Hamid-Najafi/C1-Laminar-Air-Flow-Reciculation/Docs/راهنمای نصب/RS232.jpg

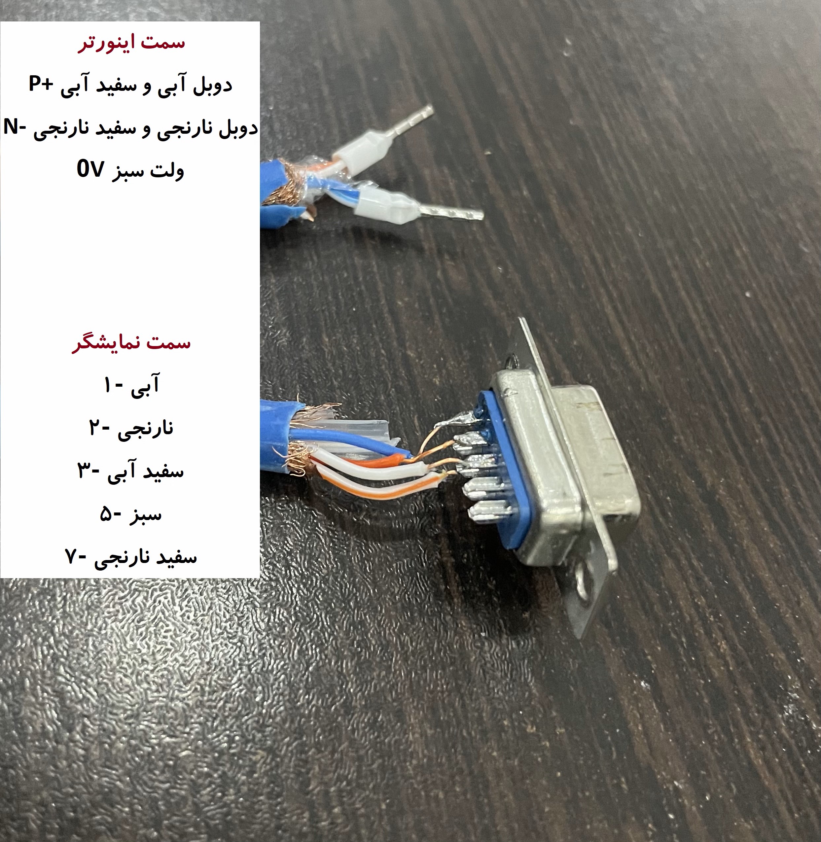
Docs/راهنمای نصب/RS232.jpg
