Hamid-Najafi/C1-Laminar-Air-Flow-Reciculation/Docs/Pictures/PHOTO-2022-05-05-09-01-35.jpg

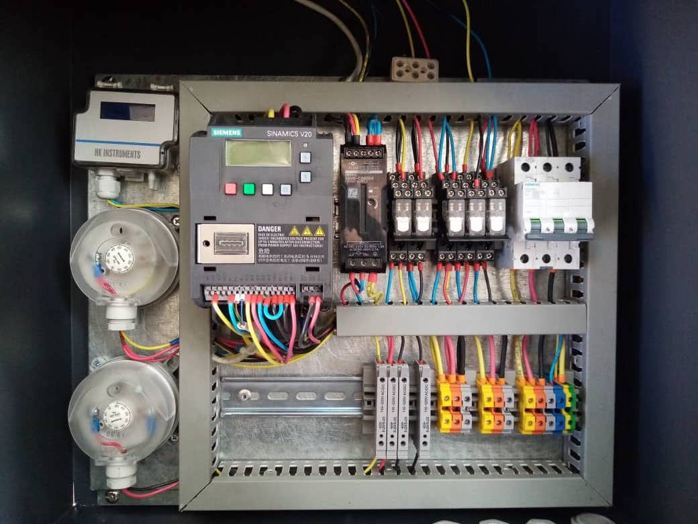
Docs/Pictures/PHOTO-2022-05-05-09-01-35.jpg
