Hamid-Najafi/C1-Laminar-Air-Flow-Reciculation/README.md

# Operating Room Laminar Air Flow Reciculation System

The system consists of Inverter (SINAMICS V20), HMI (Schneider Magelis), DPT & DPS (HK Instruments)
