Hamid-Najafi/C1-Laminar-Air-Flow-Reciculation/Docs/2828R پروپوزال/Proposal (01-04-06).pdf

## فهرست

Error! Bookmark not defined | فیلتر
Error! Bookmark not defined | نار لمی
ماژول 1 11 |
ماژول 2 12 |
فن 13 |
دی تا شی ت فن 13 |

## اتاق

ابعاد اتاق: c 300 × 580 × 710

ابعاد خروجی ها اگزاست: 4 گروه با ابعاد c 50 × 40 & 50 × 20

ابعاد فیلتر ها هوای برگشت: c 30 × 240

ابعاد درها:

در اصلی: c 210 × 150

درهای اسکراب: c 210 × 90
⁄c | سرعت خروجی هوا از لمینار: 35

میزان هوای خروجی از لمینار : FC 3200

میزان هوای ریسایکل : FC 1600

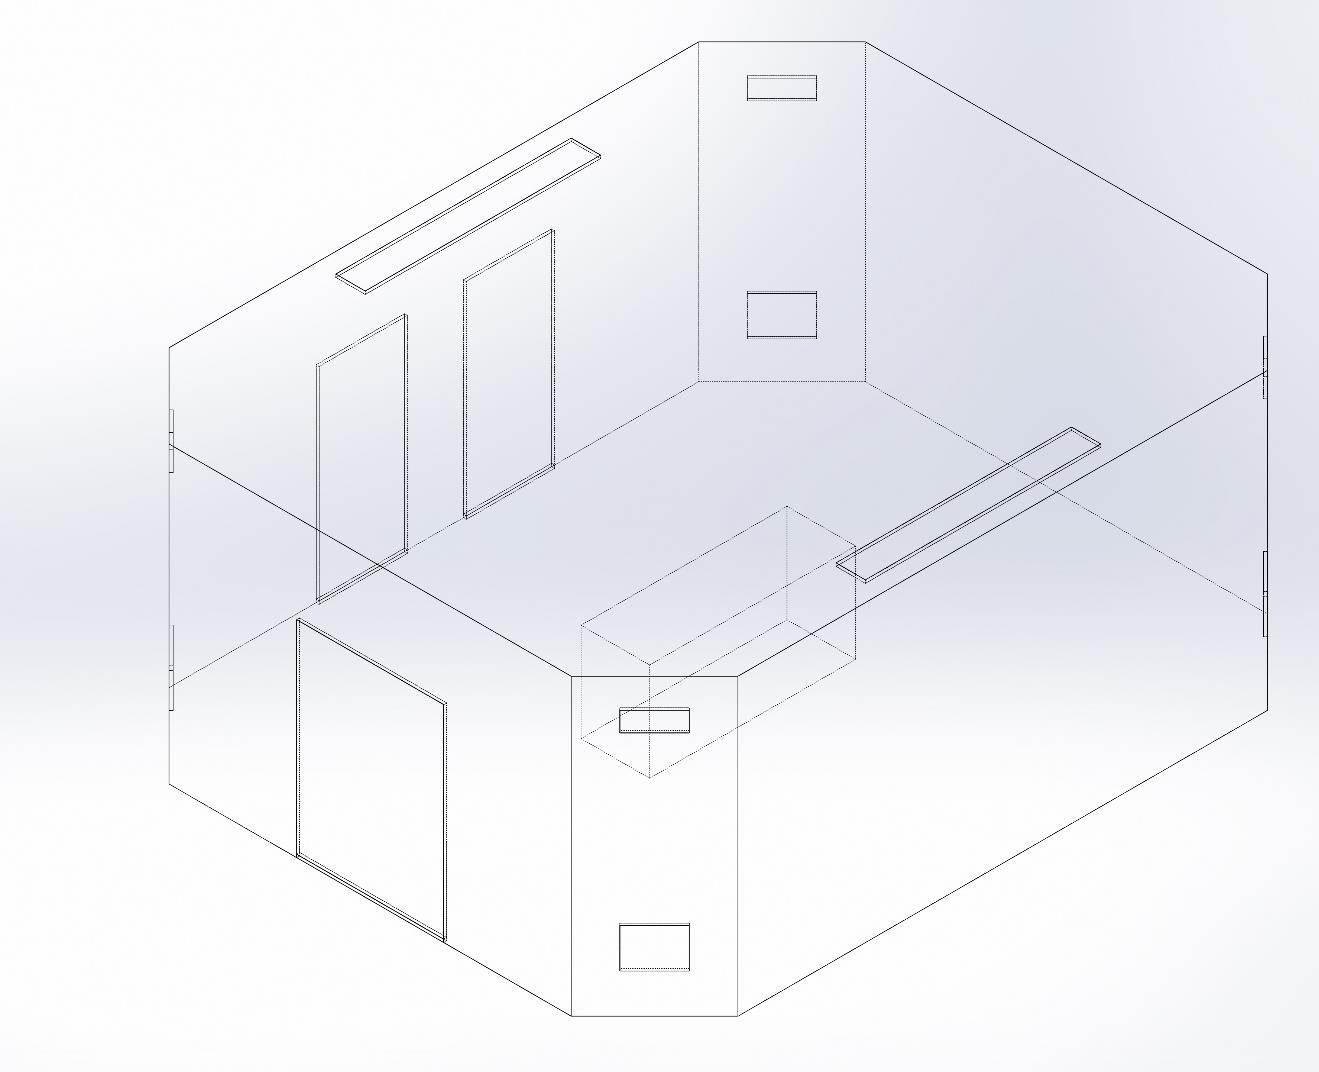
[picture p8: figure]

عکس 1 - شماتیک اتاق

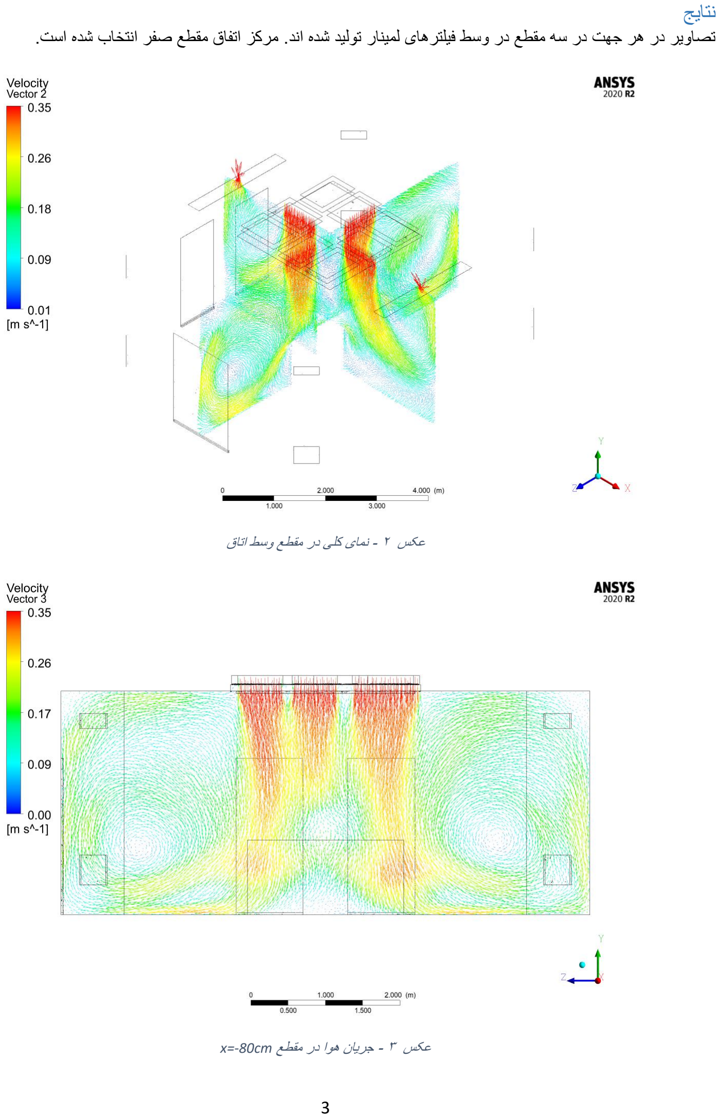
[picture p9: page 3]

نتایج
تصاویر در هر جهت در سه مقطع در وسط فیلترهای لمینار تولید شده اند. مرکز اتفاق مقطع صفر انتخاب شده است.

عکس 2 - نمای کلی در مقطع وسط اتاق

عکس 3 - جریان هوا در مقطع cm-80=x

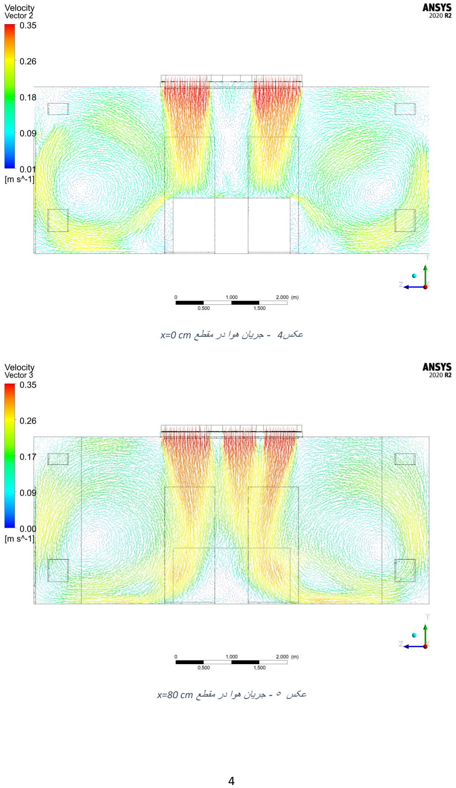
[picture p10: page 4]

عکس4 - جریان هوا در مقطع cm 0=x

عکس ⁵ - جریان هوا در مقطع cm 80=x

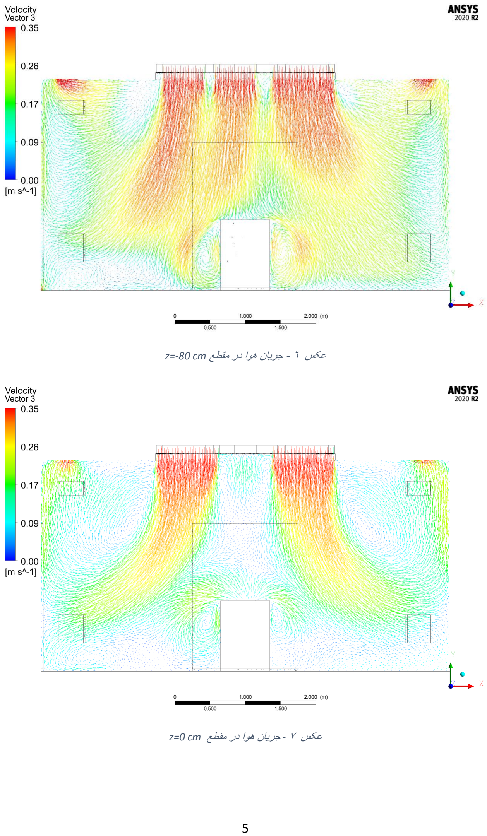
[picture p11: page 5]

عکس 6 - جریان هوا در مقطع cm -80=z

عکس 7 - جریان هوا در مقطع cm 0=z

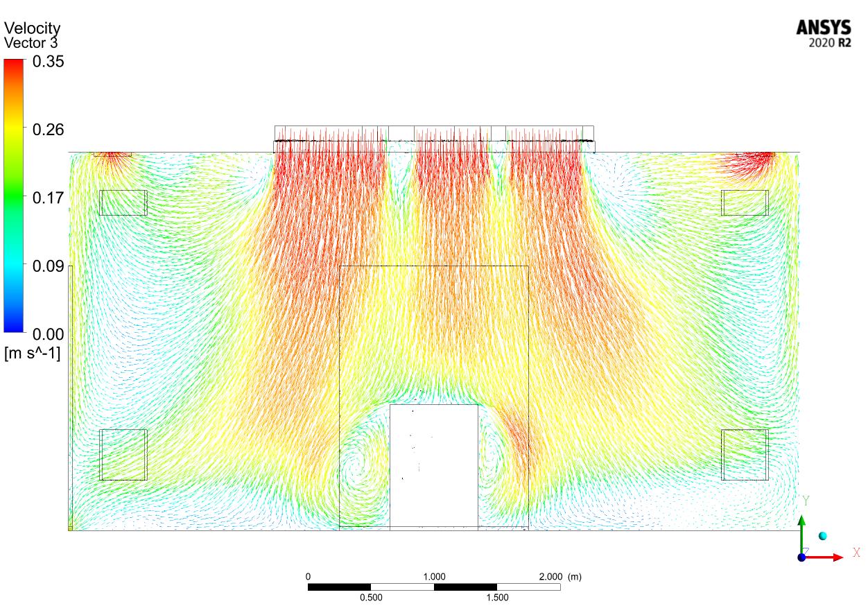
[picture p12: figure]

عکس 8 - جریان هوا در مقطع cm 80=z

## باکس فیلتر های هوای ریسایکل

برای خارج کردن و تامین هوای ریسایکل مورد نیاز برای لمینار، دو عدد باکس با مشخصات زیر طراحی شده است که هر باکس برای تامین FC 800 هوا طراحی شده اند.

مشخصات باکس
ابعاد باکس:

مشخصات فیلتر
نوع فیلتر: 7F

افت فشار اولیه فیلتر: P 65

افت فشار نهایی فلیتر : P 165

ابعاد فیلتر: c 67 × 28.7 × 28.7

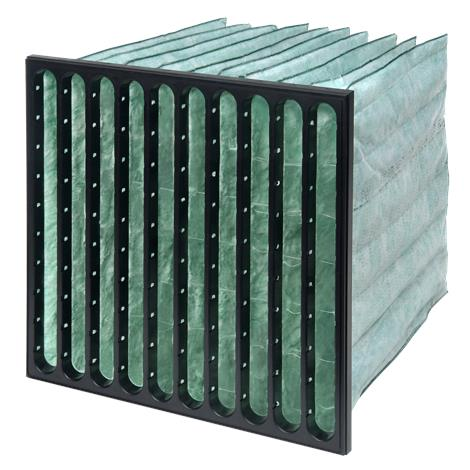
[picture p13: figure]

عکس 9 - فیلتر 7F

## کانال ها

بخش :1 کانال های رابط باکس 7F به فن ها ابعاد کانال
واحد ابعاد، سانتیمتر می باشد.

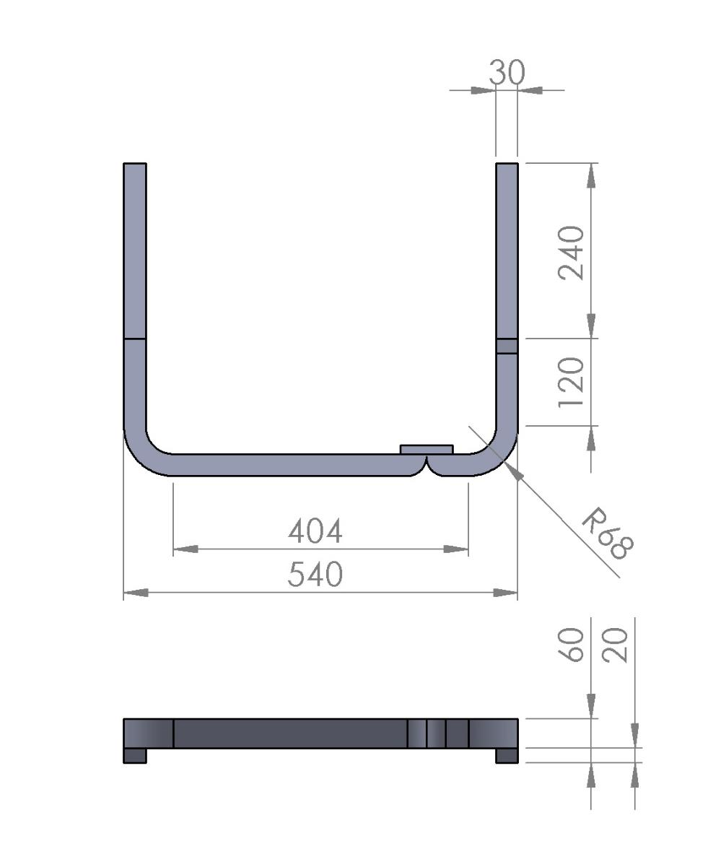
[picture p14: figure]

عکس 10 - شماتیک و ابعاد کانال 1

سرعت هوا در داخل کانال

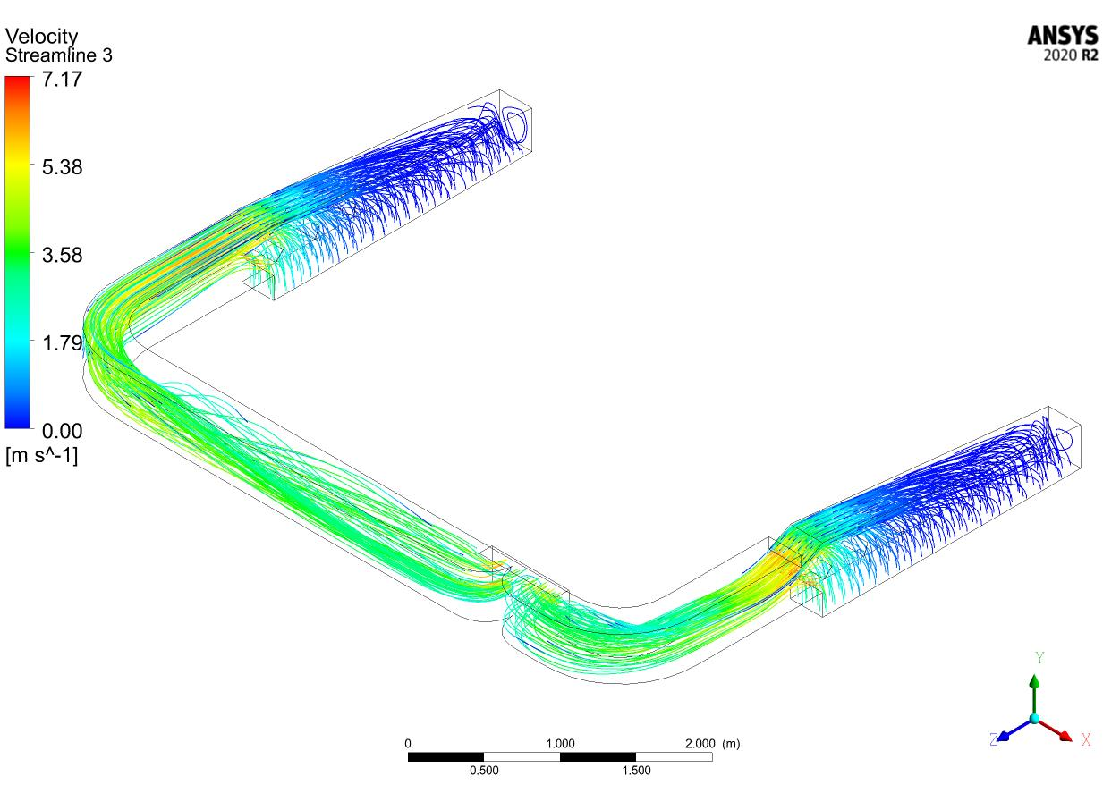
[picture p15: figure]

عکس 11 - خطوط سرعت هوا در کانال 1

نوع فیلترهای خروجی : -14HEPA

ابعاد فیلتر ها : c 15 × 61 × 90

افت فشار اولیه : P 250

افت فشار نهایی : P 500

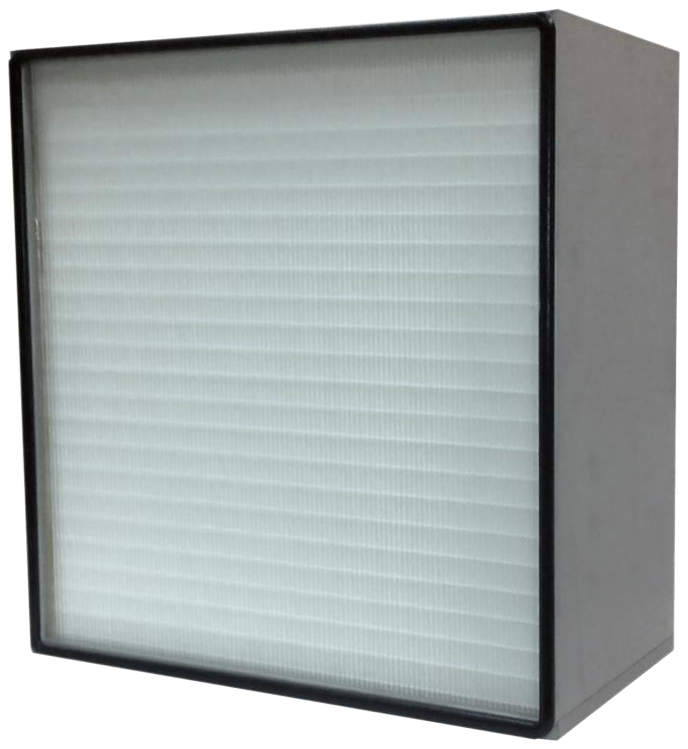
[picture p16: figure]

عکس 12 - فیلتر 14 HEPA

ماژول 1

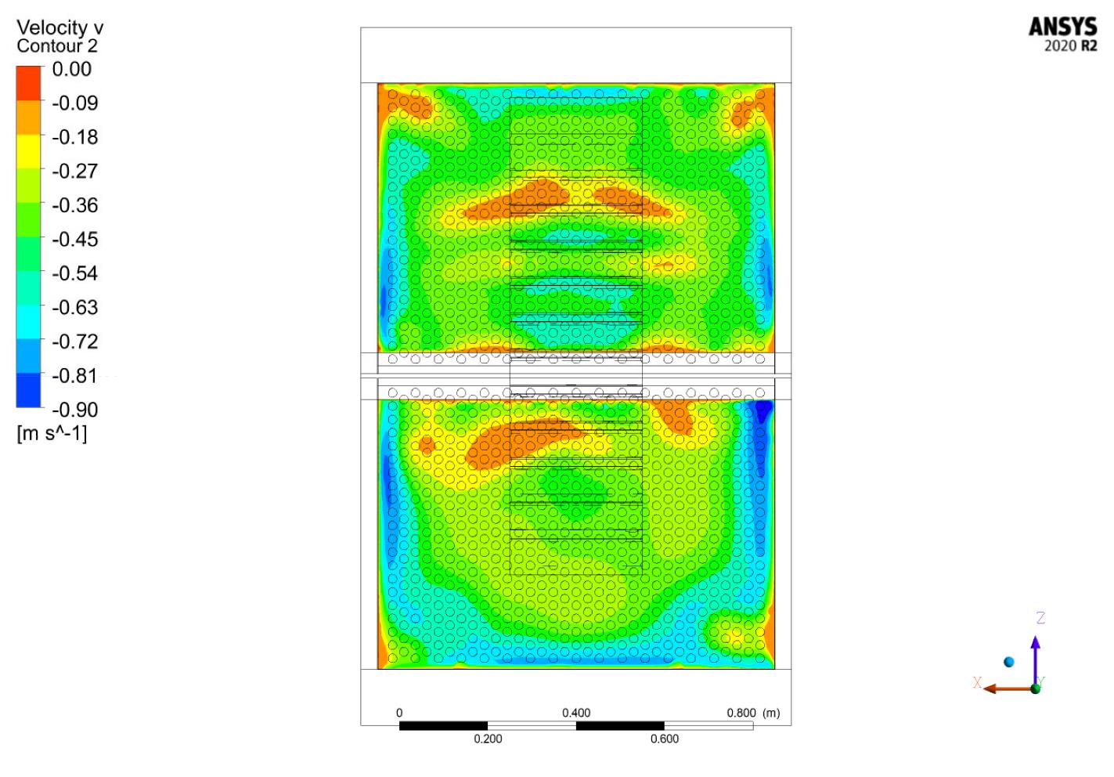
[picture p17: figure]

عکس 13 - توزیع سرعت عمودی خروجی بر روی فیلتر های ماژول 1

### ماژول 2

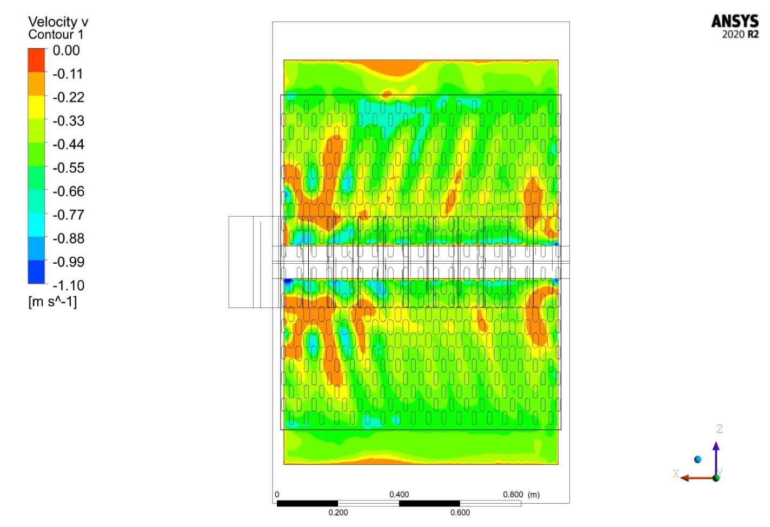
[picture p18: figure]

عکس 14 - توزیع سرعت عمودی بر روی فیلتر های ماژول 2

فن
دیتا شیت فن

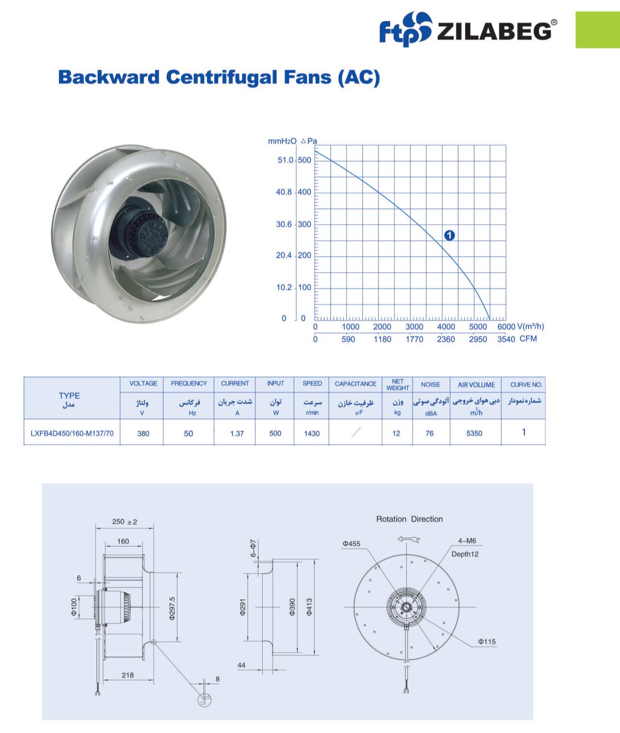
[picture p19: figure]
