Hamid-Najafi/C1-Laminar-Air-Flow-Reciculation/Docs/2828R پروپوزال/سیستم برق سانتریفیوژ (00-04-06).pdf

## سیســــــتم الكتریكـــــــال ســــــــــانتریفیوژ

A A VAKILZADEH

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
| NAME | SIGNATURE | DATE | 1401/04/06
DRAWN | | | DWG NO.
REVISION | Rev. | | SCALE:1:1 | SHEET 1 OF 5
سـطح محل | / ســـیم كابـــل مقطــع
| كابـــل-افشــــان 2.5 * 5 از منبــــع تــــامین سه فـــاز بــه تــــــابلو ســـــــــــانتریفیوژ
| كابـــل - افشــــان 1 * 4 از محل فرمــان (اضــطراری) بــه تــــــابلو ســـــــــــانتریفیوژ
| كابـــل -افشــــان 1 * 3 از تــــــابلو ســـــــــــانتریفیوژ بــه محل تــاچ پنــــل
| كابـــل شــــیلد و فویــــل- مفتولــــــی 0.25 * 6 از تــــــابلو ســـــــــــانتریفیوژ بــه محل تــاچ پنــــل

جدول كابـــل كشـــی تــــــابلو ســـــــــــانتریفیوژ اتـــاق عمل

لازم بــه ذكـر می باشــــد در جدول بـــالا موارد ذیــل رعایــت شـود

الــف: كابـــل و ســـیم بــه تــــــابلو ســـــــــــانتریفیوژ حدود دو مــتر اضــــافه در نظــر گرفتــــــه شـود

ب: بــا توجــه بــه محل جانمــــایی تـــاچ پنــــل حدود یــک مــتر كابـــل اضــــافه در نظــر گرفتــــــه شـود

ج: موارد مصــــرفی تــــــابلو ســــــــــاتریفیوژ
R, S ,T , | ارت , | نــول

جدول كابـــل كشـــی تــــــابلو ســـــــــــانتریفیوژ اتـــاق عمل

## سیســــــتم الكتریكـــــــال ســــــــــانتریفیوژ

A A VAKILZADEH

B B

C C

D D

E E

F F

| NAME | SIGNATURE | DATE | 1401/04/06
DRAWN | | | DWG NO.
REVISION | Rev. | | SCALE:1:1 | SHEET 2 OF 5

شـــــماتیک مســـیر كابــــل كشـــی تــــــابلو ســـــــــــانتریفیوژ اتـــاق عمل

كابـــل 2.5 * 5

كابـــل 1 * 4 از محل فرمـــان/اضــطراری

كابـــل 0.25 * 6

4

كابـــل 1 * 3

پیشـــــــنهاد می گـردد محل قــرار گـــیری تـــاچ پنــــل در زیــر ســاعت و كرنومـــــتر اتـــاق عمل قــرار گـــیرد و ارتفـــــاع از كـف تمــام شـده اتـــاق عمل 180 ســـــانتی مــتر باشــــد

لازم بــه ذكـر می باشــــد كه عـلاوه بـــر خاموش-روشــن نمــودن ســـــــــــانتریفیوژ از تـــاچ پنــــل نقطـــه دیگـــری جهت اضــطراری بـــودن تــــامین شـده اسـت نیــــاز بــه كابـــل فرمـــان بــه ســطح مقطــع كابـــل 1 * 4 از محل اضــطراری بــه تــــــابلو ســـــــــــانتریفیوژ مورد نیــــاز می باشــــد در صــورت صــلاح دیــد انجــام شـود. .در غــیر اینصـــــورت روی درب تــــــابلو ســـــــــــانتریفیوژ نصـــب می گـردد

## سیســــــتم الكتریكـــــــال ســــــــــانتریفیوژ

A A VAKILZADEH

B B

C C

D D

E E

F F

| NAME | SIGNATURE | DATE | 1401/04/06
DRAWN | | | DWG NO.
REVISION | Rev. | | SCALE:1:1 | SHEET 3 OF 5
| | | W تـــوان A شــدت جریــان HZ فركـــــانس V ولتــــاژ
380 | 50 | 4 | 1500

مشـخات فــــنی تــــــابلو ســـــــــــانتریفیوژ اتـــاق عمل

## سیســــــتم الكتریكـــــــال ســــــــــانتریفیوژ

A A VAKILZADEH

B B

C C

D D

E E

F F

| NAME | SIGNATURE | DATE | 1401/04/06
DRAWN | | | DWG NO.
REVISION | Rev. | | SCALE:1:1 | SHEET 4 OF 5

## سیســــــتم الكتریكـــــــال ســــــــــانتریفیوژ

A A VAKILZADEH

B B

C C

D D

E E

F F

| NAME | SIGNATURE | DATE | 1401/04/06
DRAWN | | | DWG NO.
REVISION | Rev. | | SCALE:1:1 | SHEET 5 OF 5
