Hamid-Najafi/C1-Laminar-Air-Flow-Reciculation/Docs/FlowMeter/Calc-ms-to-cfm.png

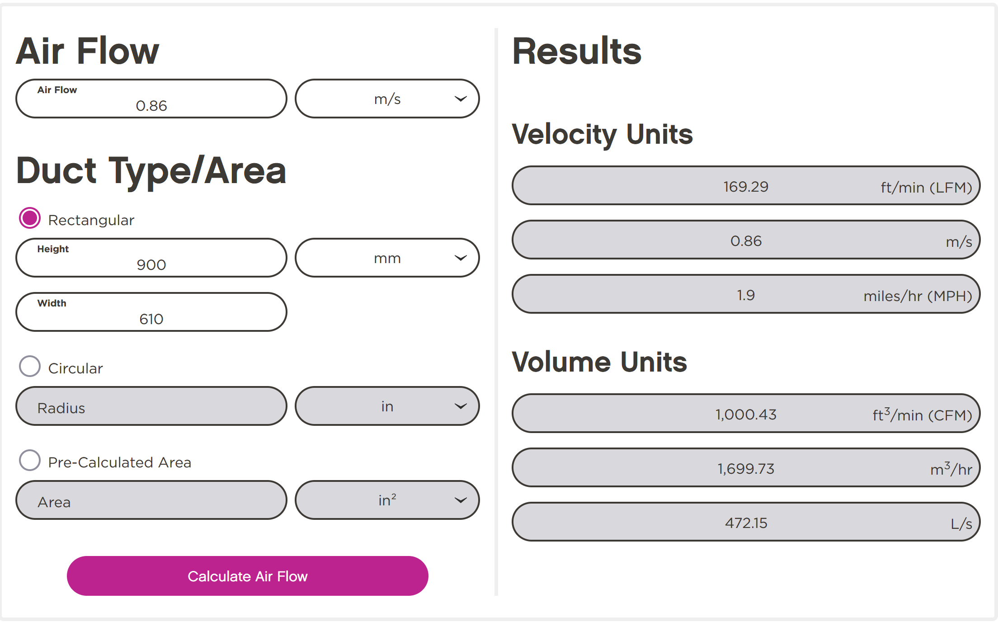
Docs/FlowMeter/Calc-ms-to-cfm.png
