Hamid-Najafi/C1-Laminar-Air-Flow-Reciculation/Docs/راهنمای نصب/سیم‌کشی تابلو.jpeg

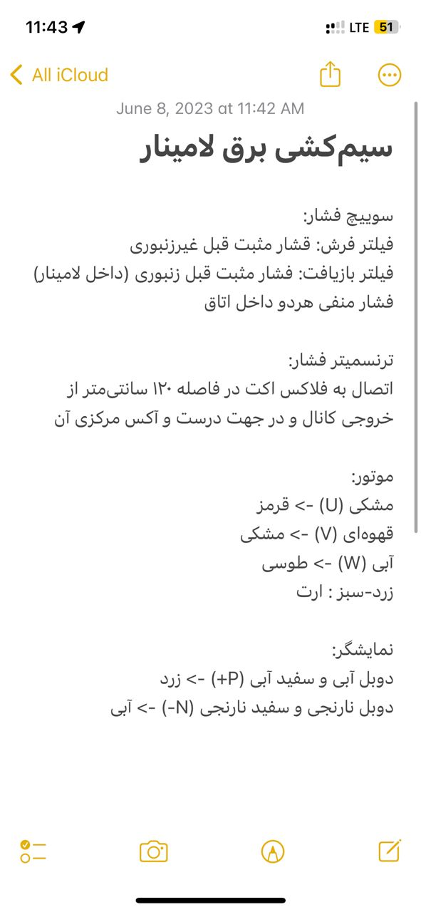
Docs/راهنمای نصب/سیم‌کشی تابلو.jpeg
