Hamid-Najafi/C1-Laminar-Air-Flow-Reciculation/Schneider Electric (Magelis HMI)/images/watermark-c1.jpg

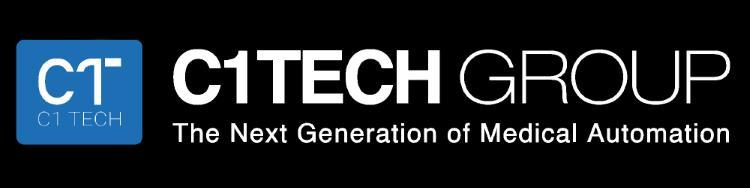
Schneider Electric (Magelis HMI)/images/watermark-c1.jpg
