Hamid-Najafi/C1-Laminar-Air-Flow-Reciculation/Siemens (SINAMICS V20)/Modbus Poll/Connection.png

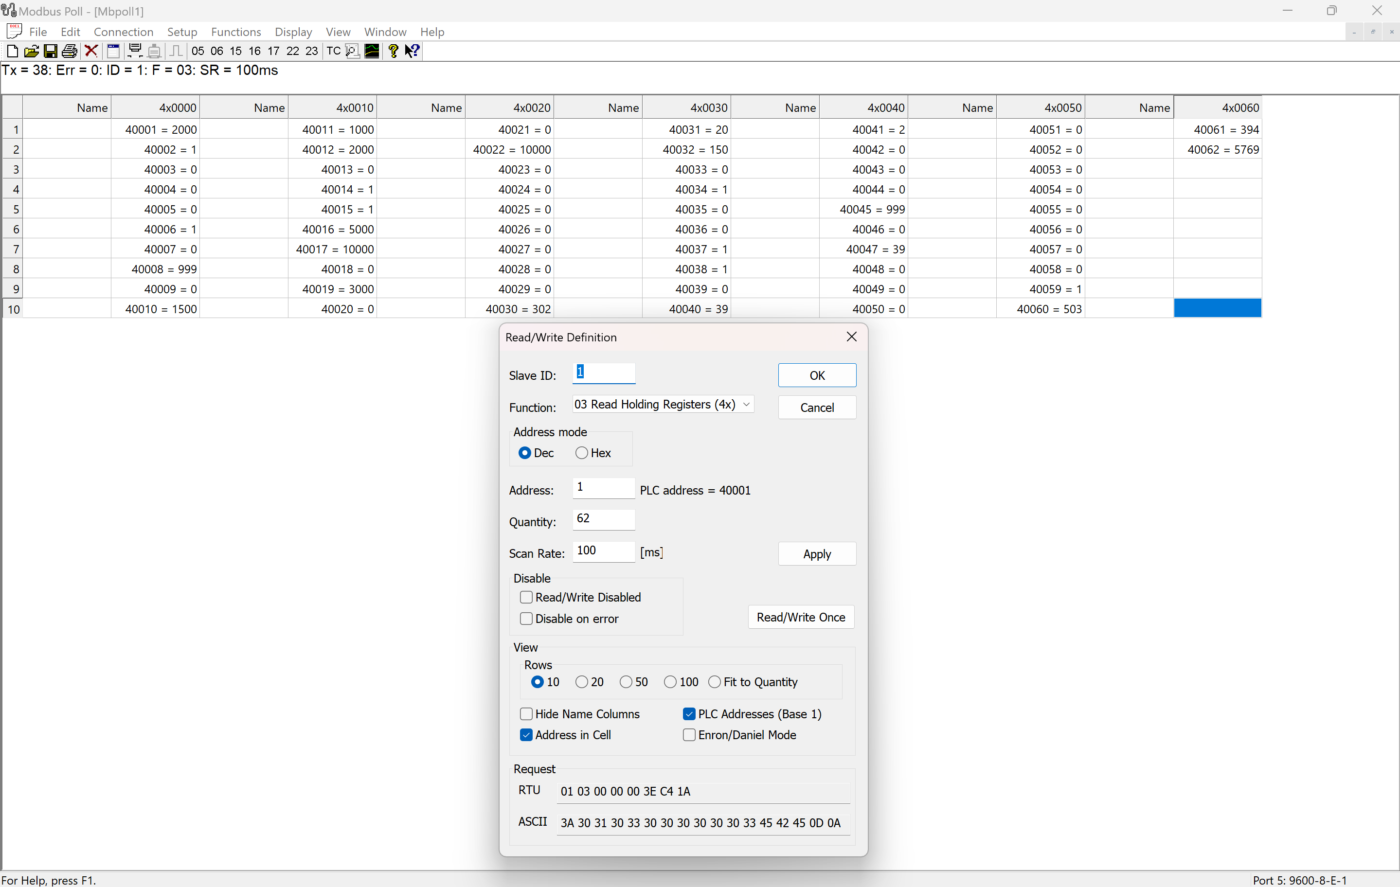
Siemens (SINAMICS V20)/Modbus Poll/Connection.png
