Hamid-Najafi/C1-Laminar-Air-Flow-Reciculation/Docs/Materials/BOM-LAF.pdf

Part # | Part Name | Description | Brand | Qty
5 | SINAMICS V20 | 6SL3210-5BE21-5UV0 | Siemens | 44
6 | HMIGXU3500 | 7 inch wide screen, Basic model, 1 serial port,
| | embedded RTC | Schneider Electric | 24
7 | Zelio Relay & Socket | RXG12BD | Schneider Electric | 0
8 | Zelio Relay & Socket | RXG22BD | Schneider Electric | 0
9 | PowerSupply | 24v, 10A | MeanWell | 44
10 | Signal Light | Red, 220V AC | ParsFanal | 100
11 | Circuit Breaker & Fuse | 6A, 6kV | Schneider Electric | 0
13 | Wire & Label | 1.5 in 10 Color, 2.5 in 3 Color - Label Pack | Other | 1
