Hamid-Najafi/C1-Laminar-Air-Flow-Reciculation/Docs/Materials/HK/DTP Flow/Flow-equations-2.0.pdf

www.hkinstruments.fi | 2.0 2022

## FLOW EQUATIONS

Manufacturer of the fan | Equation | K-factor range | Unit of the equation
FläktWoods | k q = ⋅ ∆ 1 P | 0.3...99 | m³ /s
Rosenberg | q k ⋅ ∆ = ⋅ 2 P ρ | 37...800 | m³ /h
Nicotra-Gebhardt | q k ⋅ ∆ = ⋅ 2 P * ρ | 50...4700 | m³ /h
Comefri | q k ⋅ ∆ = ⋅ 2 P ρ | 10...2000 | m³ /h
Ziehl | q = k ⋅ ∆P | 10...1500 | m³ /h
ebm-papst | q = k ⋅ ∆P | 10...1500 | m³ /h
Gebhardt | q k ⋅ ∆ = ⋅ 2 P ρ | 50...4700 | m³ /h
Nicotra | q = k ⋅ ∆P | 50...5300 | m³ /h
Common probe (e.g. FloXact) | q = k ⋅ ∆P | 0,001...9999,000 | m³ /h

Each manufacturer has its own equation, K-factor range and unit of equation (see table below). By selecting the manufacturer from the menu, correct settings for each manufacturer will automatically be used.

q = air flow | k = k-factor | ΔP = differential pressure | ρ = air density

k= C*sqrt(1.2/ρ)
ρ = air density [kg·m3] (1.2 at 20°C, 50% r.h. and 1013.2 hPa)

*
