Hamid-Najafi/C1-Laminar-Air-Flow-Reciculation/Docs/Materials/BOM-LAF.xlsx

Sheet: BillOfMaterials
Bill of Materials
 | Assembly Name : | Laminar Air Flow Recirculation Unit |  | [42]
 | Assembly Number : | --
 | Assembly Revision : | 1
 | Approval Date : | 1401/11/10
 | Part Count : | 11
 | Total Cost : | 5613500000.0ریال
Part # | Part Name | Description | Brand | Qty | Units | Unit Cost | Cost (one sys)
1 | LXFB4D450/160-M137/070 | Backward Centrifugal Fan | Ziehl-Abegg | 1 | each | 0ریال | 0ریال
2 | DPT-Flow_x0002_1000-AZ-D | Air flow and velocity transmitters | HK Instruments | 1 | each | 0ریال | 0ریال
3 | PS1500 | Mechanical differential pressure switches for air | HK Instruments | 2 | each | 0ریال | 0ریال
4 | FloXact™-L400 | Air flow and velocity transmitters | HK Instruments | 1 | each | 0ریال | 0ریال
5 | SINAMICS V20 | 6SL3210-5BE21-5UV0 | Siemens | 44 | each | 95000000ریال | 4180000000ریال
6 | HMIGXU3500 | 7 inch wide screen, Basic model, 1 serial port, embedded RTC | Schneider Electric | 24 | each | 39000000ریال | 936000000ریال
7 | Zelio Relay & Socket | RXG12BD | Schneider Electric | 0 | each | 3500000ریال | 0ریال
8 | Zelio Relay & Socket | RXG22BD | Schneider Electric | 0 | each | 3500000ریال | 0ریال
9 | PowerSupply | 24v, 10A | MeanWell | 44 | each | 10000000ریال | 440000000ریال
10 | Signal Light | Red, 220V AC | ParsFanal | 100 | each | 500000ریال | 50000000ریال
11 | Circuit Breaker & Fuse | 6A, 6kV | Schneider Electric | 0 | each | 7000000ریال | 0ریال
13 | Wire & Label | 1.5 in 10 Color, 2.5 in 3 Color - Label Pack | Other | 1 | each | 7500000ریال | 7500000ریال
 | Total |  |  | 218 |  |  | 5613500000.0ریال

Sheet: Revisions
Revision History
 | Assembly Name :
 | Assembly Number :
Revision | Revision Summary | Approval Date
0.1 | Initial release. | 2020-04-13
