Hamid-Najafi/C1-Laminar-Air-Flow-Reciculation/Docs/Materials/Ziehl-Abegg Backward Centrifugal Fan/ZILABEG.pdf

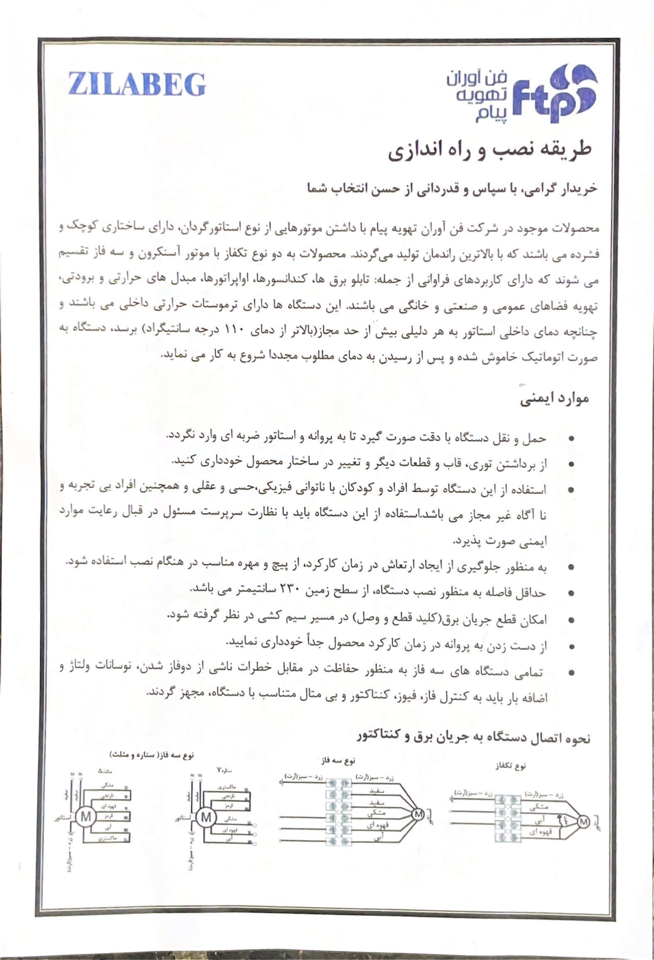
[picture p24: page 1]
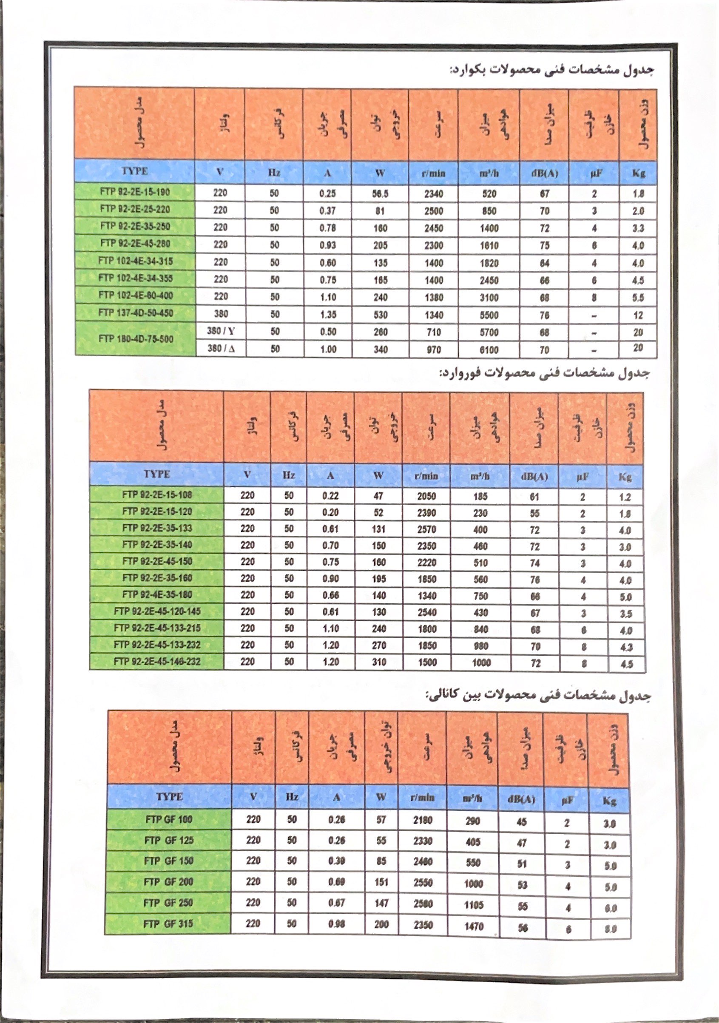
[picture p25: page 2]

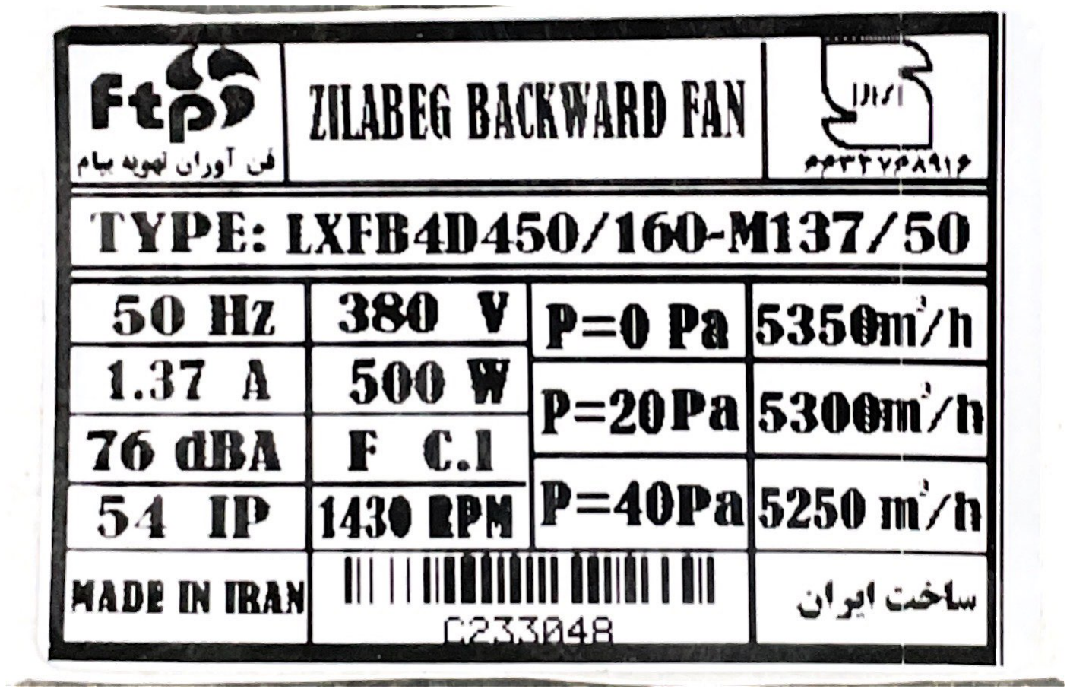
[picture p26: figure]
