Hamid-Najafi/C1-Laminar-Air-Flow-Reciculation/Schneider Electric (Magelis HMI)/Vijeo Designer Variables/SINAMICS V20 Modbus Vijeo Variable.CSV

'5.1.0 | Vijeo-Designer 6.2.6 CSV output
Type | Name | Data Type | Data Source | Dimension | Description | Initial Value | NumofBytes | Data Sharing | Alarm | Language1 ID | Alarm Message | Alarm Type | Trigger Condition | Deadband | Target | LoLo\Lo\Hi\HiHi | Minor | Major | Alarm Group | Severity | Vibration Pattern | Vibration Time | Sound File | Play Mode | Scan Group | Device Address | Bit Number | Data Format | Signed | Data Length | Offset Bit No | Bit Width | InputRange | Min | Max | DataScaling | RawMin | RawMax | ScaledMin | ScaledMax | IndirectEnabled | IndirectAddress | Retentive | LoggingGroup | LogUserOperationsOnVariable
Folder | SINAMICS_V20_VAR
Variable | SINAMICS_V20_VAR.WDOG_TIME | INT | External | 0 | HZ |  |  | None | Disable | 1 |  |  |  |  |  |  |  |  |  |  |  |  |  |  | ModbusEquipment01 | 40001 |  | BIN | 2sComplement | 16Bits |  |  | Disable |  |  | Disable |  |  |  |  | Disable |  |  |  | Disable
Variable | SINAMICS_V20_VAR.INVERTER_VER | INT | External | 0 | HZ |  |  | None | Disable | 1 |  |  |  |  |  |  |  |  |  |  |  |  |  |  | ModbusEquipment01 | 40061 |  | BIN | 2sComplement | 16Bits |  |  | Disable |  |  | Disable |  |  |  |  | Disable |  |  |  | Disable
Variable | SINAMICS_V20_VAR.WDOG_ACTION | INT | External | 0 | HZ |  |  | None | Disable | 1 |  |  |  |  |  |  |  |  |  |  |  |  |  |  | ModbusEquipment01 | 40002 |  | BIN | 2sComplement | 16Bits |  |  | Disable |  |  | Disable |  |  |  |  | Disable |  |  |  | Disable
Variable | SINAMICS_V20_VAR.DRIVE_MODEL | INT | External | 0 | HZ |  |  | None | Disable | 1 |  |  |  |  |  |  |  |  |  |  |  |  |  |  | ModbusEquipment01 | 40062 |  | BIN | 2sComplement | 16Bits |  |  | Disable |  |  | Disable |  |  |  |  | Disable |  |  |  | Disable
Variable | SINAMICS_V20_VAR.Reserved | INT | External | 0 | HZ |  |  | None | Disable | 1 |  |  |  |  |  |  |  |  |  |  |  |  |  |  | ModbusEquipment01 | 40013 |  | BIN | 2sComplement | 16Bits |  |  | Disable |  |  | Disable |  |  |  |  | Disable |  |  |  | Disable
Variable | SINAMICS_V20_VAR.FREQ_OUTPUT | INT | External | 0 | HZ |  |  | None | Disable | 1 |  |  |  |  |  |  |  |  |  |  |  |  |  |  | ModbusEquipment01 | 40024 |  | BIN | 2sComplement | 16Bits |  |  | Disable |  |  | Disable |  |  |  |  | Disable |  |  |  | Disable
Variable | SINAMICS_V20_VAR.STOP_RUN | BOOL | External | 0 | HZ |  |  | None | Disable | 1 |  |  |  |  |  |  |  |  |  |  |  |  |  |  | ModbusEquipment01 | 40035 | 00 |  |  |  |  |  |  |  |  |  |  |  |  |  | Disable |  |  |  | Disable
Variable | SINAMICS_V20_VAR.PID_FEEDBACK | INT | External | 0 | HZ |  |  | None | Disable | 1 |  |  |  |  |  |  |  |  |  |  |  |  |  |  | ModbusEquipment01 | 40047 |  | BIN | 2sComplement | 16Bits |  |  | Disable |  |  | Disable |  |  |  |  | Disable |  |  |  | Disable
Variable | SINAMICS_V20_VAR.F2_FAULT | INT | External | 0 | HZ |  |  | None | Disable | 1 |  |  |  |  |  |  |  |  |  |  |  |  |  |  | ModbusEquipment01 | 40057 |  | BIN | 2sComplement | 16Bits |  |  | Disable |  |  | Disable |  |  |  |  | Disable |  |  |  | Disable
Variable | SINAMICS_V20_VAR.F3_FAULT | INT | External | 0 | HZ |  |  | None | Disable | 1 |  |  |  |  |  |  |  |  |  |  |  |  |  |  | ModbusEquipment01 | 40058 |  | BIN | 2sComplement | 16Bits |  |  | Disable |  |  | Disable |  |  |  |  | Disable |  |  |  | Disable
Variable | SINAMICS_V20_VAR.WARNING | BOOL | External | 0 | HZ |  |  | None | Disable | 1 |  |  |  |  |  |  |  |  |  |  |  |  |  |  | ModbusEquipment01 | 40059 | 00 |  |  |  |  |  |  |  |  |  |  |  |  |  | Disable |  |  |  | Disable
Variable | SINAMICS_V20_VAR.LAST_WARNING | INT | External | 0 | HZ |  |  | None | Disable | 1 |  |  |  |  |  |  |  |  |  |  |  |  |  |  | ModbusEquipment01 | 40060 |  | BIN | 2sComplement | 16Bits |  |  | Disable |  |  | Disable |  |  |  |  | Disable |  |  |  | Disable
Variable | SINAMICS_V20_VAR.FREQ_REF | INT | External | 0 | HZ |  |  | None | Disable | 1 |  |  |  |  |  |  |  |  |  |  |  |  |  |  | ModbusEquipment01 | 40003 |  | BIN | 2sComplement | 16Bits |  |  | Disable |  |  | Disable |  |  |  |  | Disable |  |  |  | Disable
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
Variable | SINAMICS_V20_VAR.PID_OUTPUT | INT | External | 0 | HZ |  |  | None | Disable | 1 |  |  |  |  |  |  |  |  |  |  |  |  |  |  | ModbusEquipment01 | 40046 |  | BIN | 2sComplement | 16Bits |  |  | Disable |  |  | Disable |  |  |  |  | Disable |  |  |  | Disable
Variable | SINAMICS_V20_VAR.DIGITAL_IN_1 | BOOL | External | 0 |  |  |  | Read Only | Enable | 1 |  |  | when high |  |  | _\_\_\_ |  |  | DPS_AlarmGroup | 1 |  |  |  |  | ModbusEquipment01 | 40048 | 00 |  |  |  |  |  |  |  |  |  |  |  |  |  | Disable |  |  |  | Disable
Variable | SINAMICS_V20_VAR.DIGITAL_IN_2 | BOOL | External | 0 | HZ |  |  | Read Only | Enable | 1 | Recycle Filter Dirty |  | when high |  |  | _\_\_\_ |  |  | DPS_AlarmGroup | 1 | Continuous | 10 |  |  | ModbusEquipment01 | 40049 | 00 |  |  |  |  |  |  |  |  |  |  |  |  |  | Disable |  |  |  | Disable
Variable | SINAMICS_V20_VAR.DIGITAL_IN_3 | BOOL | External | 0 | HZ |  |  | None | Disable | 1 |  |  |  |  |  |  |  |  |  |  |  |  |  |  | ModbusEquipment01 | 40050 | 00 |  |  |  |  |  |  |  |  |  |  |  |  |  | Disable |  |  |  | Disable
Variable | SINAMICS_V20_VAR.DIGITAL_IN_4 | BOOL | External | 0 | HZ |  |  | None | Disable | 1 |  |  |  |  |  |  |  |  |  |  |  |  |  |  | ModbusEquipment01 | 40051 | 00 |  |  |  |  |  |  |  |  |  |  |  |  |  | Disable |  |  |  | Disable
Variable | SINAMICS_V20_VAR.FAULT | BOOL | External | 0 | HZ |  |  | None | Disable | 1 |  |  |  |  |  |  |  |  |  |  |  |  |  |  | ModbusEquipment01 | 40054 | 00 |  |  |  |  |  |  |  |  |  |  |  |  |  | Disable |  |  |  | Disable
Variable | SINAMICS_V20_VAR.LAST_FAULT | INT | External | 0 | HZ |  |  | None | Disable | 1 |  |  |  |  |  |  |  |  |  |  |  |  |  |  | ModbusEquipment01 | 40055 |  | BIN | 2sComplement | 16Bits |  |  | Disable |  |  | Disable |  |  |  |  | Disable |  |  |  | Disable
Variable | SINAMICS_V20_VAR.F1_FAULT | INT | External | 0 | HZ |  |  | None | Disable | 1 |  |  |  |  |  |  |  |  |  |  |  |  |  |  | ModbusEquipment01 | 40056 |  | BIN | 2sComplement | 16Bits |  |  | Disable |  |  | Disable |  |  |  |  | Disable |  |  |  | Disable
Variable | SINAMICS_V20_VAR.STW_ControlWord | INT | External | 0 |  |  |  | None | Disable | 1 |  |  |  |  |  |  |  |  |  |  |  |  |  |  | ModbusEquipment01 | 40100 |  | BIN | 2sComplement | 16Bits |  |  | Disable |  |  | Disable |  |  |  |  | Disable |  |  |  | Disable
Variable | SINAMICS_V20_VAR.HSW_SpeedSetpoint | INT | External | 0 |  |  |  | None | Disable | 1 |  |  |  |  |  |  |  |  |  |  |  |  |  |  | ModbusEquipment01 | 40101 |  | BIN | 2sComplement | 16Bits |  |  | Disable |  |  | Disable |  |  |  |  | Disable |  |  |  | Disable
Variable | SINAMICS_V20_VAR.ZSW_StatusWord | INT | External | 0 |  |  |  | None | Disable | 1 |  |  |  |  |  |  |  |  |  |  |  |  |  |  | ModbusEquipment01 | 40110 |  | BIN | 2sComplement | 16Bits |  |  | Disable |  |  | Disable |  |  |  |  | Disable |  |  |  | Disable
Variable | SINAMICS_V20_VAR.HIW_ActualSpeed | DINT | External | 0 |  |  |  | None | Disable | 1 |  |  |  |  |  |  |  |  |  |  |  |  |  |  | ModbusEquipment01 | 40111 |  | BIN | 2sComplement | 32Bits |  |  | Disable |  |  | Disable |  |  |  |  | Disable |  |  |  | Disable
