Hamid-Najafi/C1-Laminar-Air-Flow-Reciculation/Docs/Materials/Ziehl-Abegg Backward Centrifugal Fan/LXFB4D450-160-M137-70.jpg

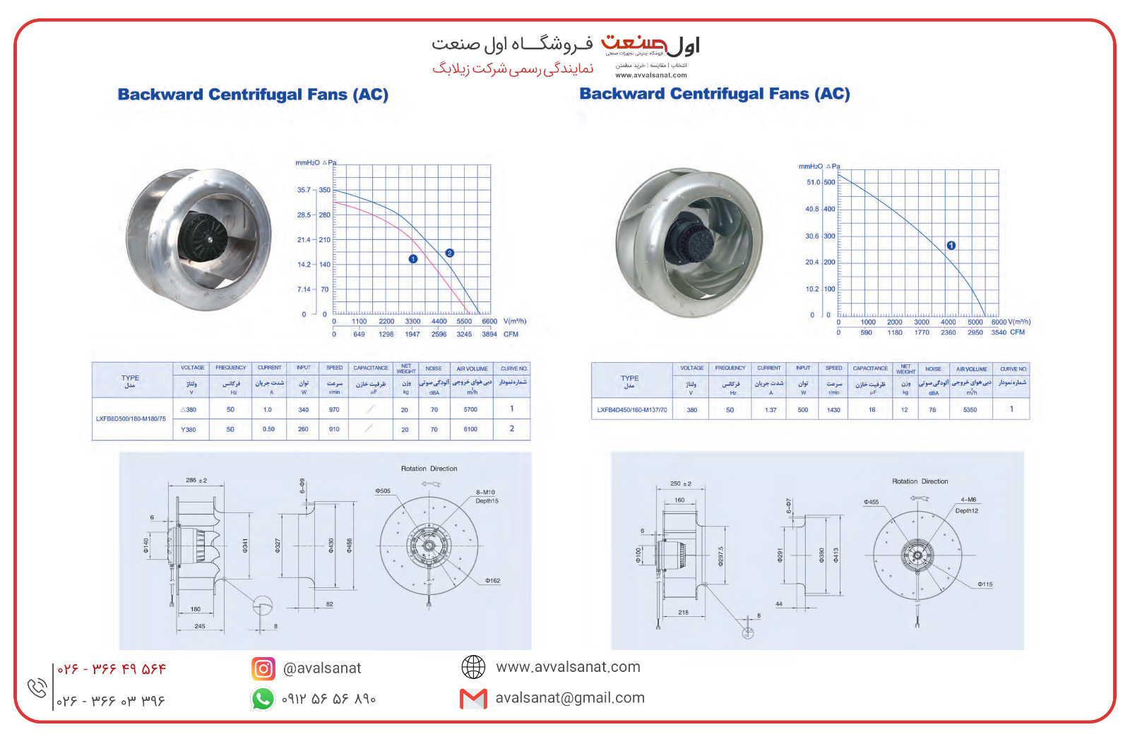
Docs/Materials/Ziehl-Abegg Backward Centrifugal Fan/LXFB4D450-160-M137-70.jpg
