Hamid-Najafi/C1-Laminar-Air-Flow-Reciculation/(list of files, cad)

Other CAD files:
Docs/+20_+25.dwg
Docs/Laminar-Air-Flow-Reciculation.dwg
