Hamid-Najafi/C1-Laminar-Air-Flow-Reciculation/Siemens (SINAMICS V20)/MenuGuide.pdf

### Commissioning 5.1 The built-in Basic Operator Panel (BOP)

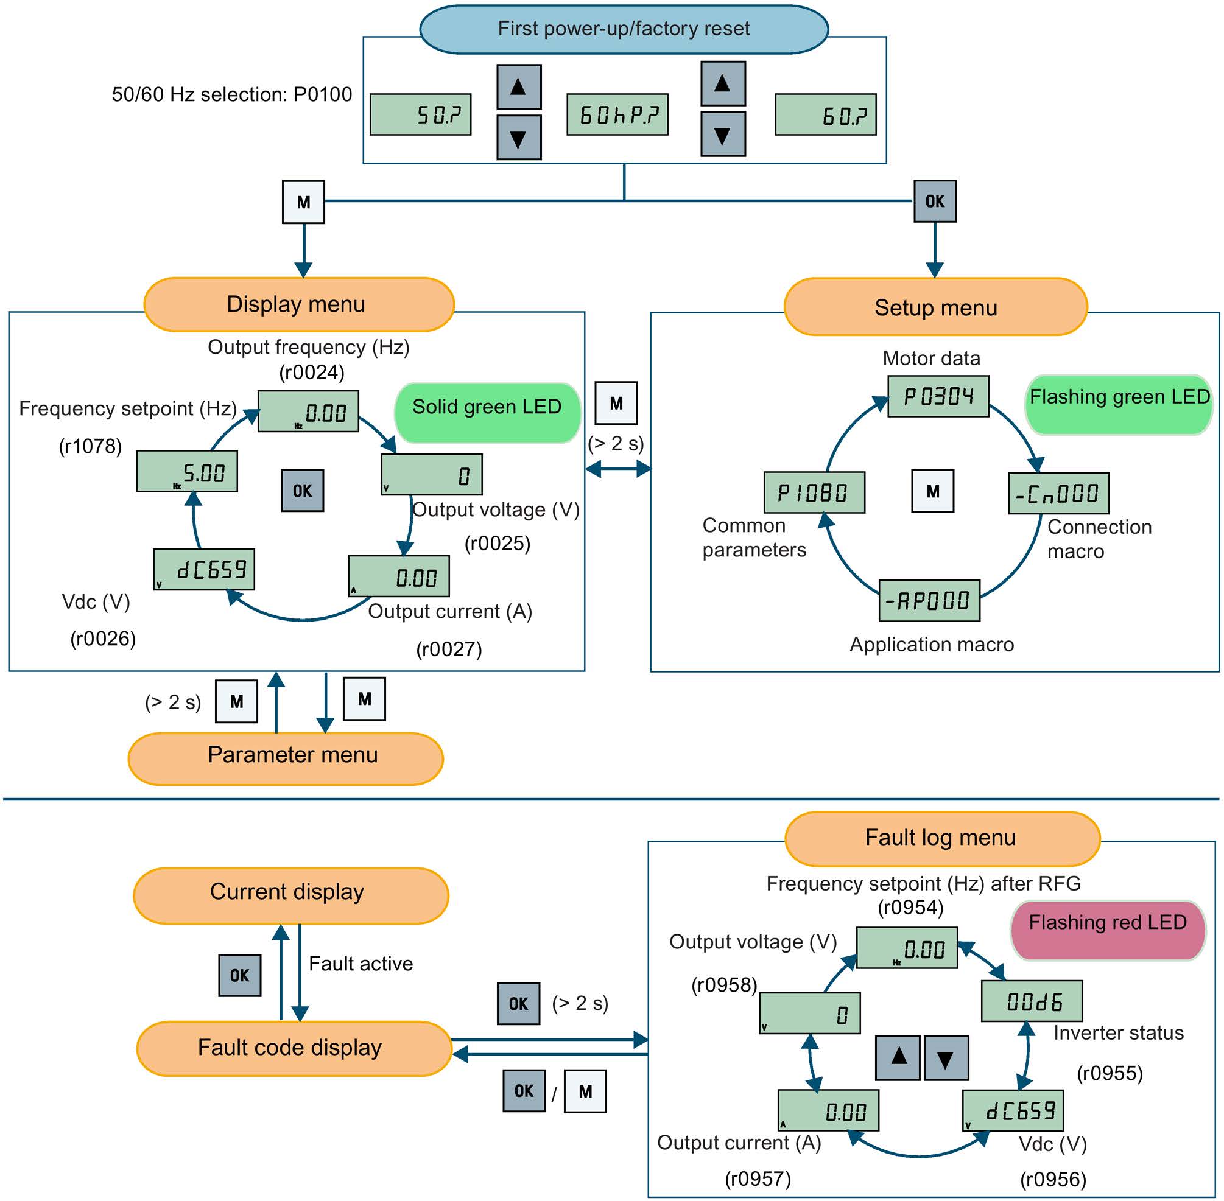
[picture p28: figure]

SINAMICS V20 Inverter
52 | Operating Instructions, 09/2014, A5E34559884
