Hamid-Najafi/C1-Laminar-Air-Flow-Reciculation/HK Instruments (DPT-Ctrl)/DPT-Flow-Commissioning.txt

Manufacturer: Common Probe
Response Time: 1 s
V Output Max: 5000 cfm
Flow Unit: cfm
P Output Max: 250 Pa
Press. Unit: Pa
K-Value: 145
(According to motor spec and duct size)
Formula Unit: l/s
