Hamid-Najafi/C1-Laminar-Air-Flow-Reciculation/Siemens (SINAMICS V20)/V20-Commissioning.txt

Factory Reset:
P0010: 30
P0970: 21

Cn000 -> Cn011
{
P0700: 1 -> 5
P1000: 1 -> 5
P2023: 1 -> 2
P2010: 6 -> 6
P2021: 1 -> 1
P2022: 1000 -> 1000
P2014: 2000 -> 100
P2034: 2 -> 2
P2035: 1 -> 1
}

AP000 -> AP020
{
P1110: 0 -> 1
P1300: 0 -> 7
P1200: 0 -> 2
P1210: 1 -> 2
P1080: 0 -> 20
P1120: 10 -> 10
P1121: 10 -> 20
}

- Quick Commisioning
{
P0003: 3
P0010: 0 -> 1 Begin Quick Commisioning
P0100: 0
P0304: 380
P0305: 2.74
P0307: 1.0
P0308: Default (0.820)
P0310: Default (50.00)
P0311: 1430
P0335: Default (0)
P0640: Default (150)
P0700: 5
P1000: 5
P1080: AP020 Default (20.00) ---->>>> 5.00
P1082: 47.7
P1120: Default (10.00)
P1121: AP020 Default (20.00)
P1300: AP020 Default (7)
P3900: 0 -> 2 End Quick Commisioning
P1900: Default (0)
}

- After Quick Commisioning
P1040: 47.70 (MOP Setpoint)
P2014: 0 Disable modbus wWatchDog feature

=================================================
MODBUS:
40101 Setpoint Frequency
32767 -> 100 Hz
16384 -> 50 Hz
15630 -> 47.7 Hz (MAX! 1430 RPM for our Fans)
12288 -> 37.5 Hz
8192  -> 25 Hz
4096  -> 12.5 Hz
1638  -> 5 Hz
0000  -> 0.00 Hz
=================================================
Modified Parameters
P0004: 24
Cn000
AP000
P0201: 5769, 48, 134, 
P0304: 380
P0305: 2.74
P0307: 1.0
P0308: 0.820
P0311: 1430, 1425, 1425
P0341: 0.0024, 0.0038, 0.0038
P0344: 10.00, 13.7, 13.7
P0344: 10.00, 13.7, 13.7
P0346: 0.136, 0.126, 0.126
P0347: 0.340, 0.315, 0.315
P0350: 5.6549, 5.1203, 5.1203
P0354: 3.1549, 2.8579, 2.8579
P0356: 12.744, 10.842, 10.842
P0358: 13.146, 11.187, 11.187
P0360: 416.05, 351.68, 351.68
P0700: 2, 1, 1
P0717: 11
P0753: 100,3
P0840: 2036.0, 722.3, 19.0
P0844: 2036.1, 19.1, 19.1
P0848: 2036.2, 1, 1
P0852: 2036.3, 1, 1
P1000: 2, 1, 1 ????
P1001: 10.0, 10.0, 10.0
P1002: 15.0, 15.0, 15.0
P1003: 25.0, 25.0, 25.0
P1004: 50.0, 50.0, 50.0
P1035: 2036.d, 19.d, 19.d
P1036: 2036.E, 19.E, 19.E
P1040: 45.0, 5.0, 5.0
P1055: 2036.8, 19.8, 19.8
P1056: 2036.9, 0, 0
P1059: 5.00, 5.00, 5.00
P1070: 2018.1, 1050.0, 1050.0
P1082: 49.00, 50.00, 50.00
P1101: 2.00, 2.00, 2.00
P1113: 2036.b, 19.b, 19.b
P1140: 2036.4, 1, 1
P1141: 2036.5, 1, 1
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
P2004: 1.88 (or 2?), 3.00, 3.00
P2014: 100, 0
P2023: 2
P2104: 2036.7, 0, 0
P2111: 1
P2150: 3.00, 3.00, 3.00
P2155: 30.00, 30.00, 30.00
P2157: 30.00, 30.00, 30.00
P2159: 30.00, 30.00, 30.00
P2164: 3.00, 3.00, 3.00
P2167: 1.00, 1.00, 1.00
P2182: 5.00, 5.00, 5.00
P2183: 30.00, 30.00, 30.00
P2184: 50.00, 50.00, 50.00
P2185: 6.68, 10.05, 10.05
P2187: 6.68, 10.05, 10.05
P2189: 6.68, 10.05, 10.05
P2202: 20.00, 20.00, 20.00
P2240: 1.80, 0.00, 10.00 
P2253: 2250.0, 2250.0, 0
P2280: 8.000
P2285: 1.355
P0004: 0
