Hamid-Najafi/C1-Laminar-Air-Flow-Reciculation/Docs/Laminar-Air-Flow-Reciculation.pdf

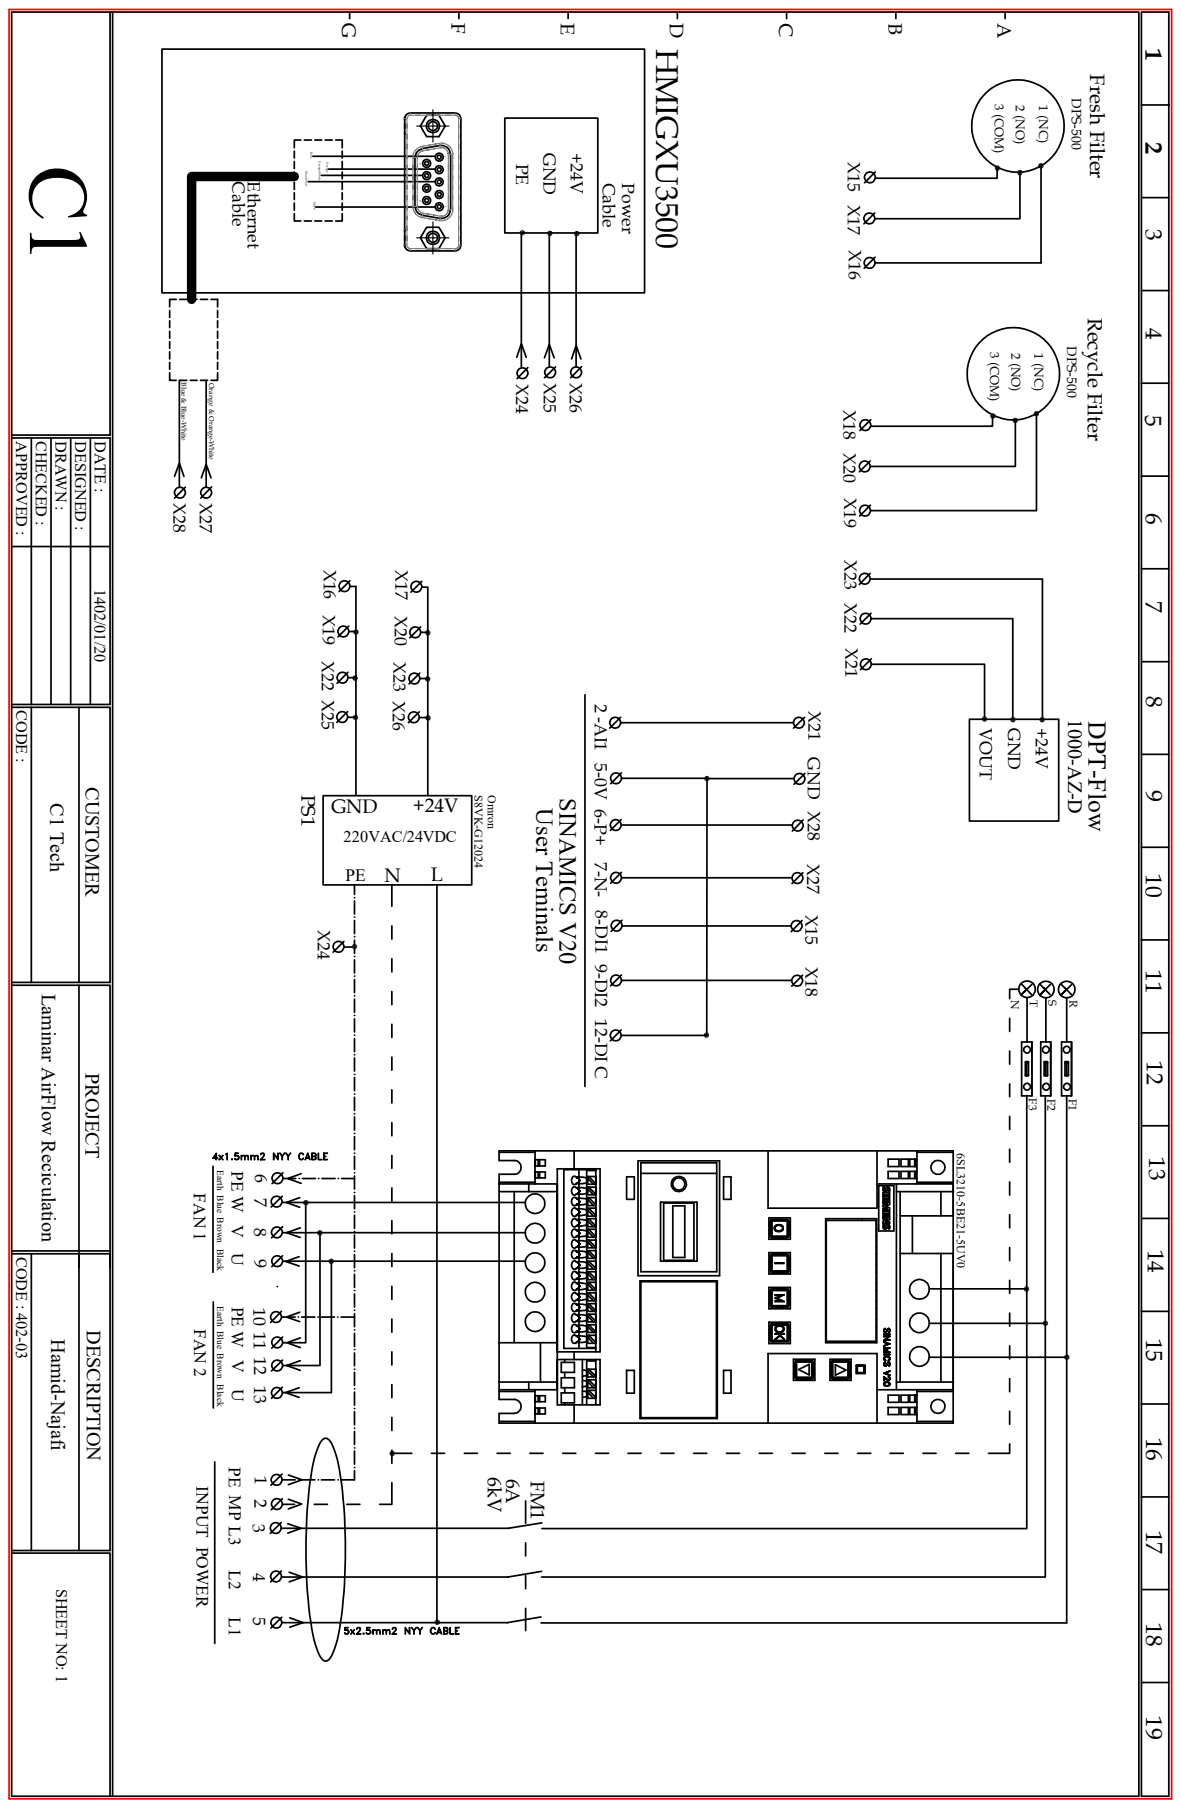
[picture p29: page 1]
220VAC/24VDC; GND; GND +24V PE; Cable Power HMIGXU3500 Orange Orange-White Blue Blue-White; Green C1 Tech Laminar AirFlow Reciculation Hamid-Najafi; X24 X25 X26 X28 X27 Cable Ethernet Blue & Blue-White; Orange & Orange-White; DPS-500 3 (COM); Fresh FilterX15; Recycle Filter X17 X16; VOUT GND +24V X23 X22 X21 X17 X20 X23 X16 X19 X22 X25; X26 X24 PE MP L3 L2 L1 PE W V U FAN 1; Blue Brown Black Earth PE W V U FAN 2; Blue Brown Black Earth INPUT POWER; X21 X28 X27 SINAMICS V20 User Teminals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

GFEDCBA 16 15 14 13 11 10 12 9 7 8 6 5 4 2 3 1 APPROVED : CHECKED : DRAWN : DESIGNED : DATE : CUSTOMER PROJECT DESCRIPTION SHEET NO: 1 17 18 19 CODE : 402-03 CODE : 1402/01/20 C1 11 12 13 7 8 9 6 10 FM1 3 4 5 2 1 F3F2F1 NTSR 6A
